rua0/Duke_Xprize_Hybrid/Past_reports_stuffs/2017S/Hybrid gas electric Power for Drone-UAS Sp17/coupling.jpg

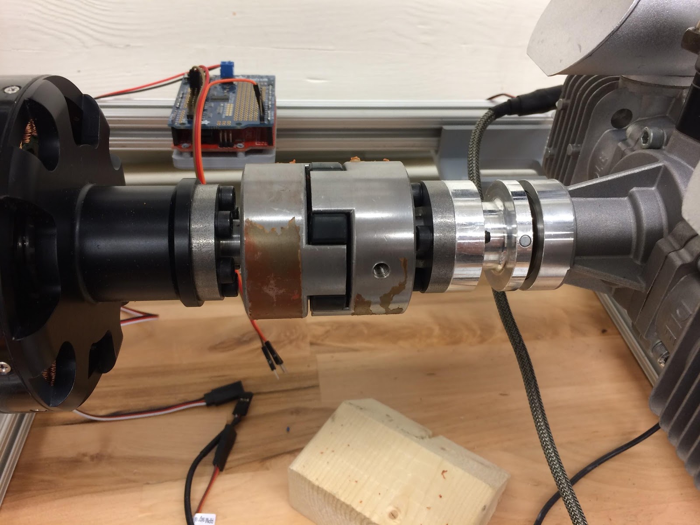
Past_reports_stuffs/2017S/Hybrid gas electric Power for Drone-UAS Sp17/coupling.jpg
