rua0/Duke_Xprize_Hybrid/README.md

# Duke_Xprize_Hybrid
Codes and documents for a hybrid-electrical system used for Duke Ocean Xprize entry
