rua0/Duke_Xprize_Hybrid/Past_reports_stuffs/F17 Hybrid/Copy of  9_22_16 - Zach Meeting.docx

Zach Meeting

1. NEVER Go straight from 1 to 6. There is an order somewhere we need to follow. Going from 1 to 6 will fuck up the ESC
  a. This is probably what we did week 1 and why it does not work anymore
2. RC Mimic attempts to get access to programming mode, but it is VERY finicky. Not deterministic, just need luck to get it right
  a. Once this happens, there are instructions for programming
  b. Let’s try to get a joystick to program?

Let’s split into 2 projects:

1. Joystick + ESC Happiness
  a. Get a joystick and try to program the ESC (higher probability than programming with Arduino)
    i. ESC still may lose programming afterwards
  b. If not work, fall back on using rc_mimic and dumb luck
2. Relay switching system
  a. Relay to switch between discharging and charging batteries
  b. Would need to program ESC to stop sending signals once charging
3. Potentially research more ESCs to see if something would fit our purpose better
