rua0/Duke_Xprize_Hybrid/Past_reports_stuffs/F17 Hybrid/Copy of 9_17_16 - Questions for Zach.docx

Does the wire polarization ( red-red and black-black) to battery need to be flipped when charging vs. receiving power?

Need to verify which direction to run motor for proper battery charge polarity

Ask about their troubleshooting

If they ever had any esc unhappy beep problems

Was the ESC programming through arduino straightforward?

Zach Meeting

1. NEVER Go straight from 1 to 6. There is an order somewhere we need to follow. Going from 1 to 6 will fuck up the ESC
  a. This is probably what we did week 1 and why it does not work anymore
2. RC Mimic attempts to get access to programming mode, but it is VERY finicky. Not deterministic, just need luck to get it right
  a. Once this happens, there are instructions for programming
  b. Let’s try to get a joystick to program?
1. Joystick + ESC Happiness
2. Relay switching system
