rua0/Duke_Xprize_Hybrid/Past_reports_stuffs/F17 Hybrid/Copy of ESC Programming.docx

5 is good

6 is good

7 is bad

Throttle

Max PL: 1925 us (closed) (134 deg)

Min PL: 1250 us (open) (68 deg)

Choke

Max PL: (Fully opened, maximum air) -60%, 1200 us (63 deg)

Min PL: -35 (max gas, final air), 650 us (10 deg)
