rua0/Duke_Xprize_Hybrid/Past_reports_stuffs/2017S/Hybrid gas electric Power for Drone-UAS Sp17/Circuit diagrams.docx

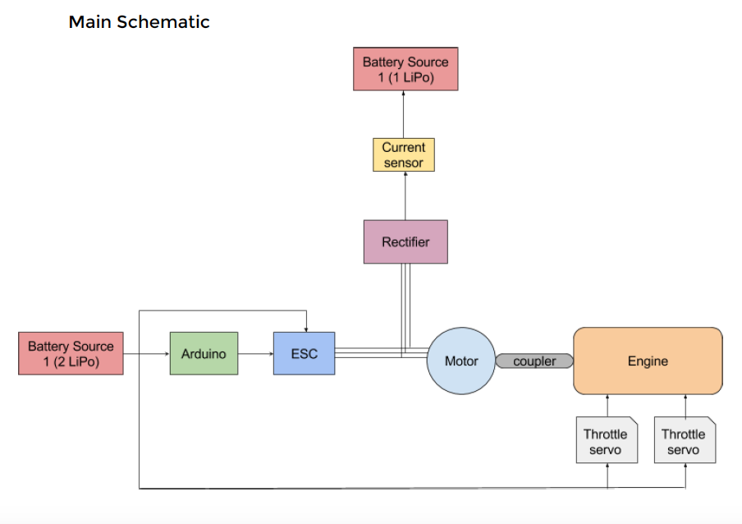
[picture p17: figure]

Load Resistance

(series)

Our schematic diagram only differs in that the load resistance has been connected to the rectifier. However everything else is the same.

This is how all the main components are connected together.

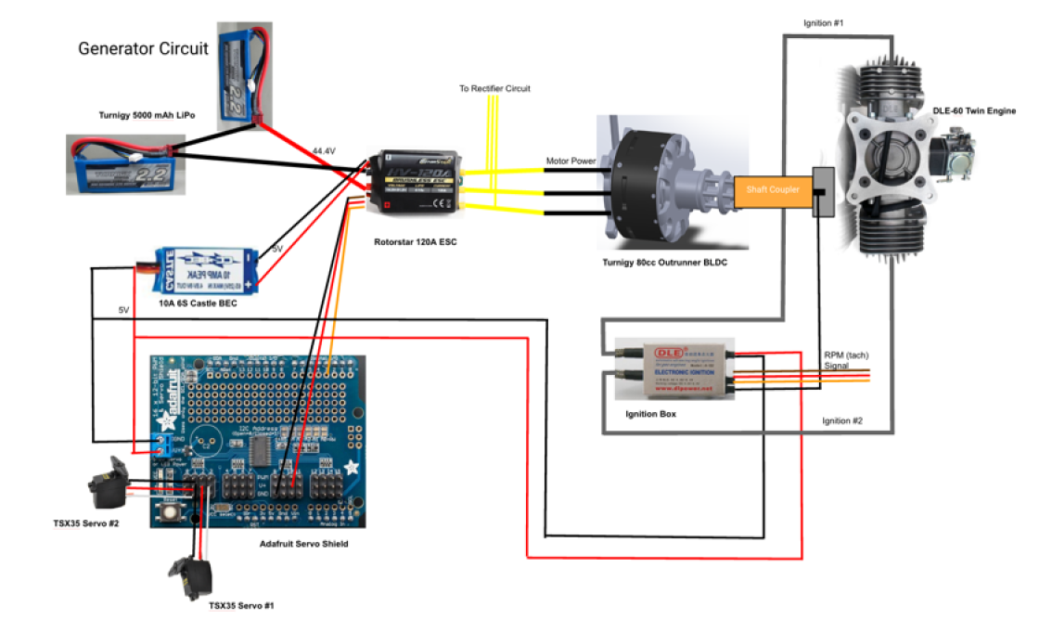
[picture p18: figure]

This is the rectifier circuit which now has the load resistance connected to it:

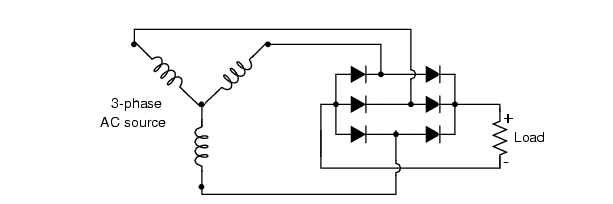
[picture p19: figure]
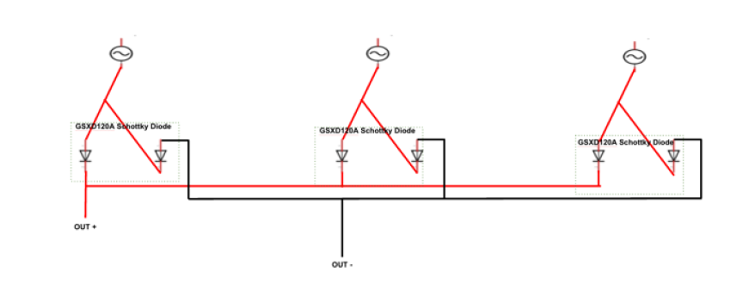
[picture p20: figure]
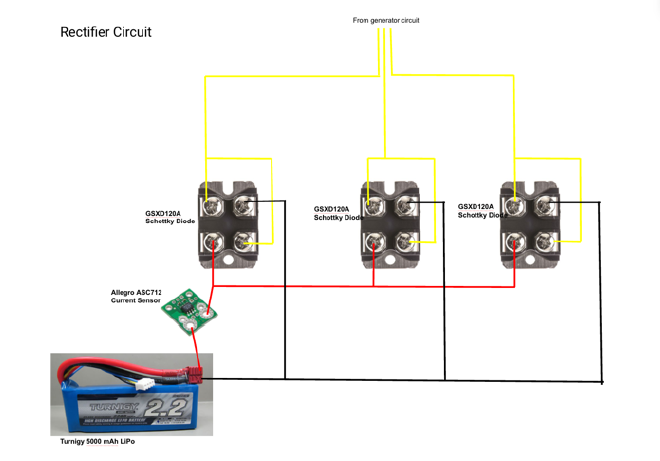
[picture p21: figure]
