rua0/Duke_Xprize_Hybrid/Past_reports_stuffs/2017S/Hybrid gas electric Power for Drone-UAS Sp17/Programmable ESC/Copy of Hybrid Gas-Electric Electronic Speed Controller (Final).docx

# Hybrid Gas-Electric Electronic Speed Controller

Will Floyd-Jones

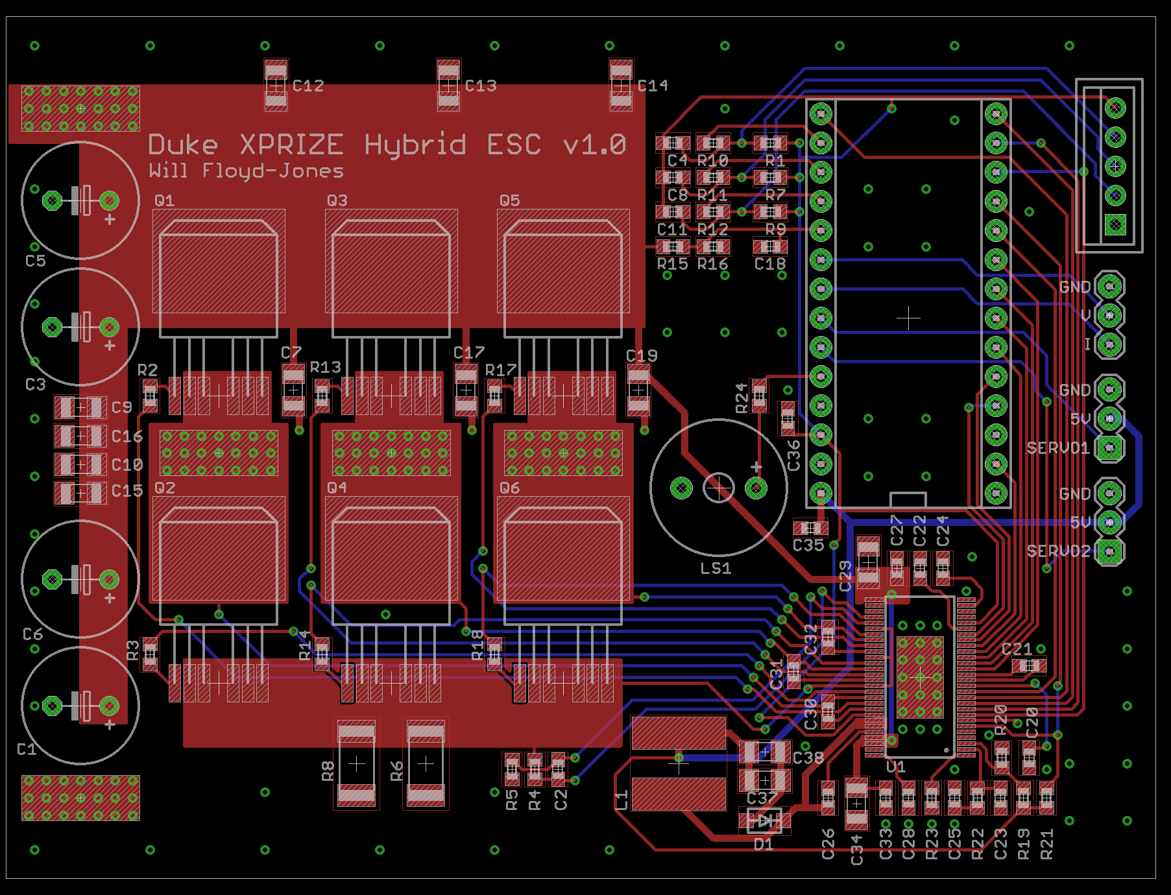
[picture p32: figure]

Overview

This report documents progress I have made on the electronic speed controller (ESC) for the hybrid gas-electric power system. I have designed a printed circuit board for the ESC which integrates a Teensy microcontroller, gate driver IC, hall effect sensor inputs, a buzzer, and connectors to interface with other components in the hybrid system. In addition, I have written Teensy firmware to interface the microcontroller with the gate driver IC and apply currents to the motor phases according to the hall effect state and throttle position. The ESC is able to spin a large brushless DC motor with hall effect sensors spaced 120 electrical degrees apart from one another.

Instructors: Dr. Martin Brooke

ECE 496 - Advanced Robotic System Design

Duke University

Table of Contents

Background 2

Schematic 5

Layout 8

Assembly 11

Hall Effect Sensor Board 11

Code 12

Status and the Way Forward 14

Background

Brushless DC motors are gaining in popularity due to their efficiency advantage over their brushed counterparts. The brushes of a conventional motor are used to mechanically commutate the device- meaning that they apply current to the coil windings to swap the direction of the magnetic field. This makes turning a brushed DC motor very simple: apply DC current and the motor will spin. However, these brushes can wear out over time and efficiency losses occur due to arcing and suboptimal management of the magnetic field orientation.

Brushless motors require the system designer to electronically commutate the device- a microcontroller is used to apply currents to the coil windings based on the position of the rotor relative to the stator. The stator coil generates a rotating magnetic field which drags the rotor through each successive revolution. Since the relative position of the rotor must be known to determine which direction currents should travel through the stator windings, three hall-effect sensors are often embedded in the stator and used to indicate 6 unique rotor positions. As the rotor magnet passes over one of the hall-effect sensors, its output will switch from low to high. The figure below illustrates a brushless DC motor in a inrunner topology- that is, the rotor is on the inside and the stator is on the outside- with hall-effect sensors on the non-driving end.

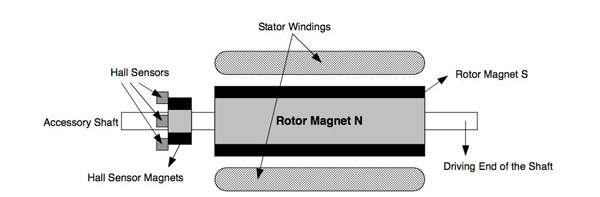
[picture p33: figure]
Microchip Hall sensors

Figure 1: Inrunner-style brushless DC motor

There are more sophisticated ways to detect the rotor position- encoders which give far better resolution than the simple hall effect sensor topology, or a sensorless strategy which measures the back-EMF from the rotating motor’s phases to infer the rotor position. These complicate the system design but can be used to enhance reliability and efficiency. However, in the hybrid gas-electric system on the drone, the ESC only exists to start the motor. This means that it does not have to be very efficient since it is not on for very long and only drains the battery which is used only to start the motor. The sensorless strategy relies on back-EMF produced by a rotating motor- meaning that it cannot be used to start rotating the motor. Typically this is overcome by rotating the motor open-loop until it is going fast enough to produce sufficient back-EMF, but the motor torque will be low while it is being spun open-loop because the magnetic field will not be well-oriented. Again, the ESC in the hybrid system is for starting the motor- nothing else- so it would be foolish to employ a sensorless strategy where the motor would struggle to produce enough torque to drive the gas engine.

The stator of a brushless DC motor is comprised of three sets of coil phase windings, which are attached at a common point in the center as shown in Figure 2 below. The motor has three terminals- one for each stator phase- which connect to the ESC’s drive phases. These drive phases, shown in Figure 3 below, apply currents to the stator using three MOSFET pairs- which are used to drive one motor phase high and another low while the third is left floating. It is up to the system designer to ensure that the high side and the low side of a single drive phase are never on at the same time- this would cause a short between the positive and negative battery terminals through the drive phase’s MOSFETs. If hall-effect sensors are used for determining the rotor position, a simple look-up table can be used to select which MOSFETs to turn on based on the hall-effect sensor states.

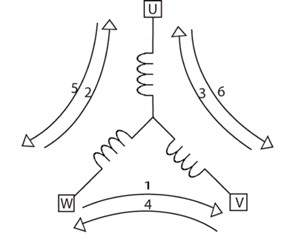
[picture p34: figure]
Atmel Coil-energizing sequence

Figure 2: Y-Configuration of stator coils

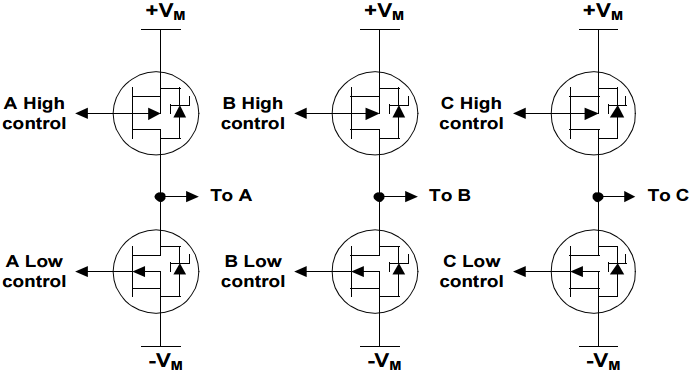
[picture p35: figure]

Figure 3: 3- Half H-bridge MOSFET drive phase schematic

Schematic

The schematic capture and PCB layout for this project were done in EAGLE. I selected EAGLE over more capable tools such as Altium Designer because this PCB is not too complex and EAGLE is still the standard among hobbyists and should be the easiest to use if this design is re-used or modified in the future. The schematic contains sections for decoupling capacitors, the hall-effect sensor inputs, connectors, the gate driver IC, the MOSFET drive stages, and the Teensy microcontroller.

The hall-effect sensor portion of the schematic consists of a 5-pin polarized JST connector for power, ground, and the three inputs. The inputs are pulled up to 3.3V (the microcontroller digital IO operating voltage) by a 10k resistor because the hall effect sensors are open-collector. They are filtered with a simple RC low-pass filter with a cutoff frequency of 16 Khz and a 10% to 90% rise time of 22 µs. These values can easily be changed later as necessary by replacing either the resistor or capacitor (or both) from the board.

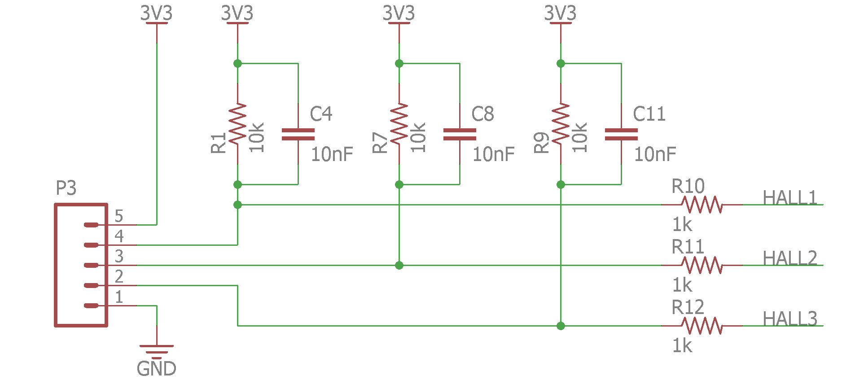
[picture p36: figure]

Figure 4: Hall-effect sensor input schematic

The drive stages portion of the schematic consists of the canonical configuration of three half-H bridges used to pull each of the motor terminals to V+ or ground. The MOSFETs used can conduct up to 240A. At the bottom, the node labeled “FET_LOW” connects the source terminals of the low side MOSFETs to ground through a pair of shunt resistors in parallel, which are used to measure the sum of the currents through the motor. Due to a slight schematic error, the current shunt amplifier output of the DRV8301 IC is not wired to the microcontroller, so gate current cannot be monitored in this board revision.

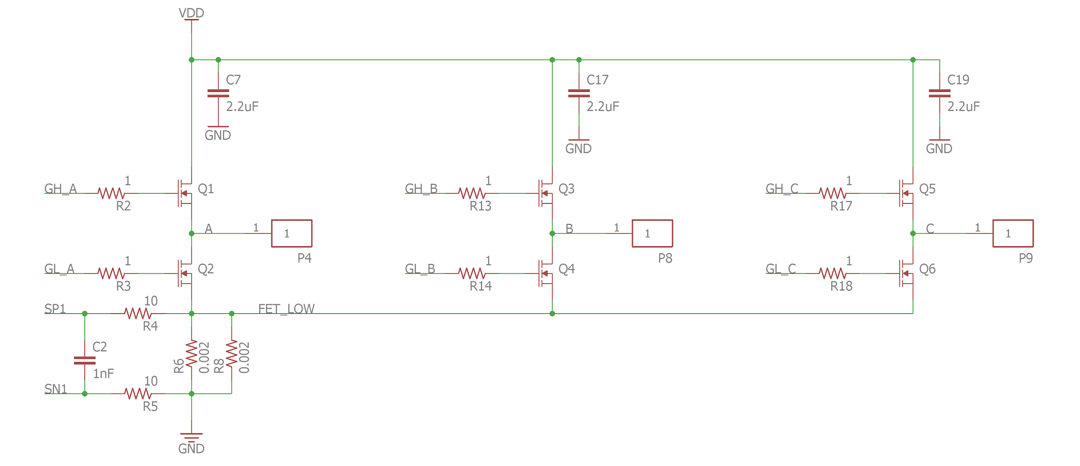
[picture p37: figure]

Figure 5: Drive Stages schematic

The DRV8301 gate driver portion of the schematic is for the most part the schematic recommended in the Texas Instruments application note. The ICs integrated buck converter is used to produce the 5V rail for the rest of the chip.

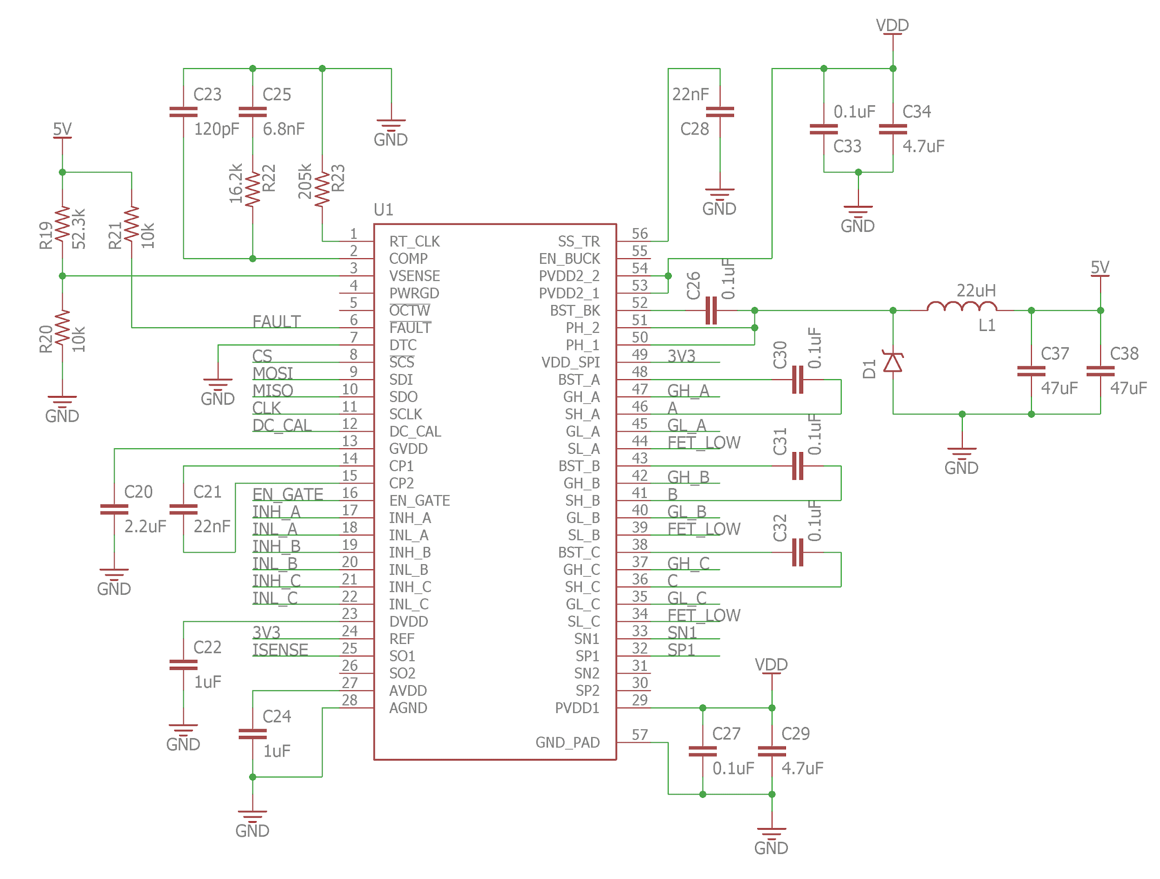
[picture p38: figure]

Figure 6: Gate Driver IC Schematic

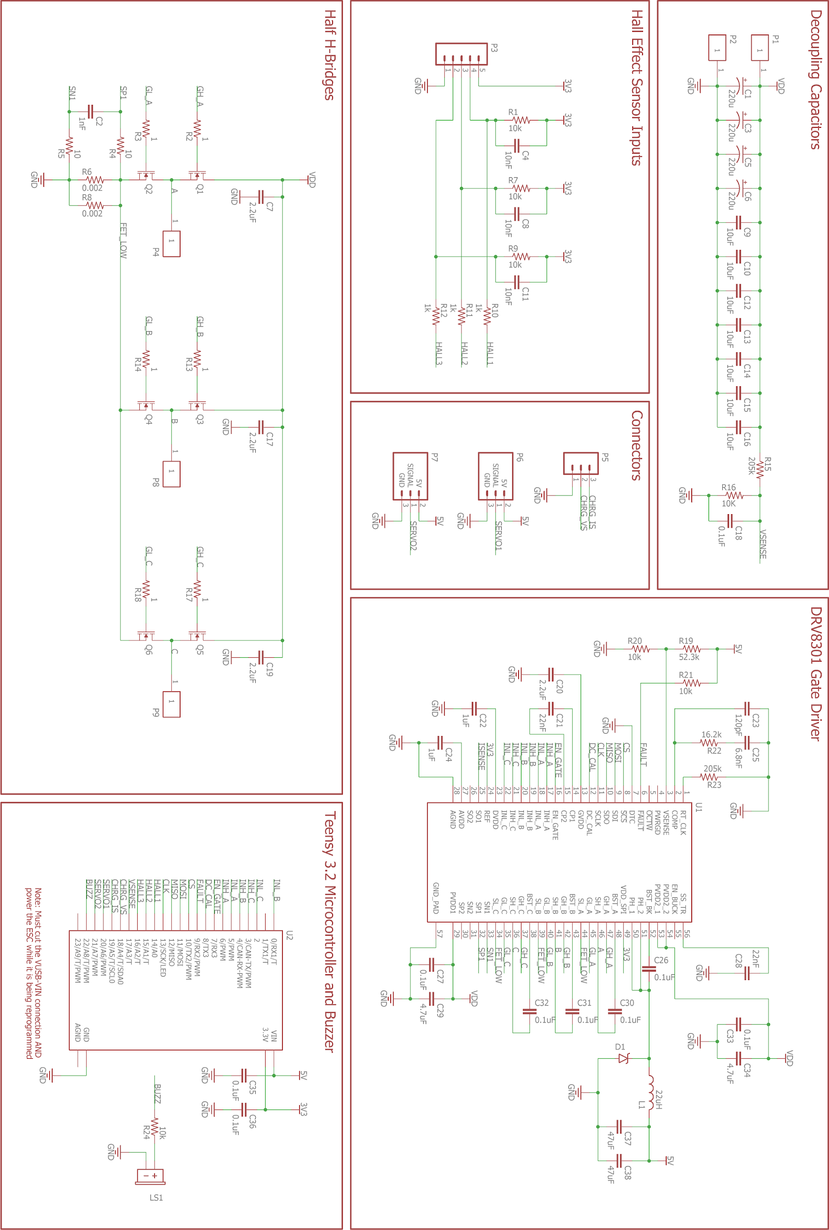
[picture p39: figure]

Figure 7: Complete Schematic

Layout

The PCB is laid-out with the drive stages on the left side and the microcontroller and gate driver IC on the right side. The drive stages are positioned such that enough current can flow between the motor terminal and the MOSFET gates; the traces connecting the high and low side MOSFETs to the motor terminal are each about 12 mm wide. Given that the circuit board will likely be fabricated with 1 oz/ft² copper and most of the trace is actually covered with solder, each trace should easily conduct more than 30A. Under the drive stages is the low-side current sensor system, which shunt current through a pair of 2 mΩ resistors of size 2512 in parallel and amplify the voltage using the gate driver IC. This copper pour should be large enough to conduct the current necessary to start the gas motor. The left side of the board also contains the decoupling capacitors on the input and pads to connect to the silicon wires of the battery connector and the motor phase wires. These pads are wide enough to accommodate 10 AWG wire and have vias through them to help prevent mechanical stress from ripping the pad off the PCB.

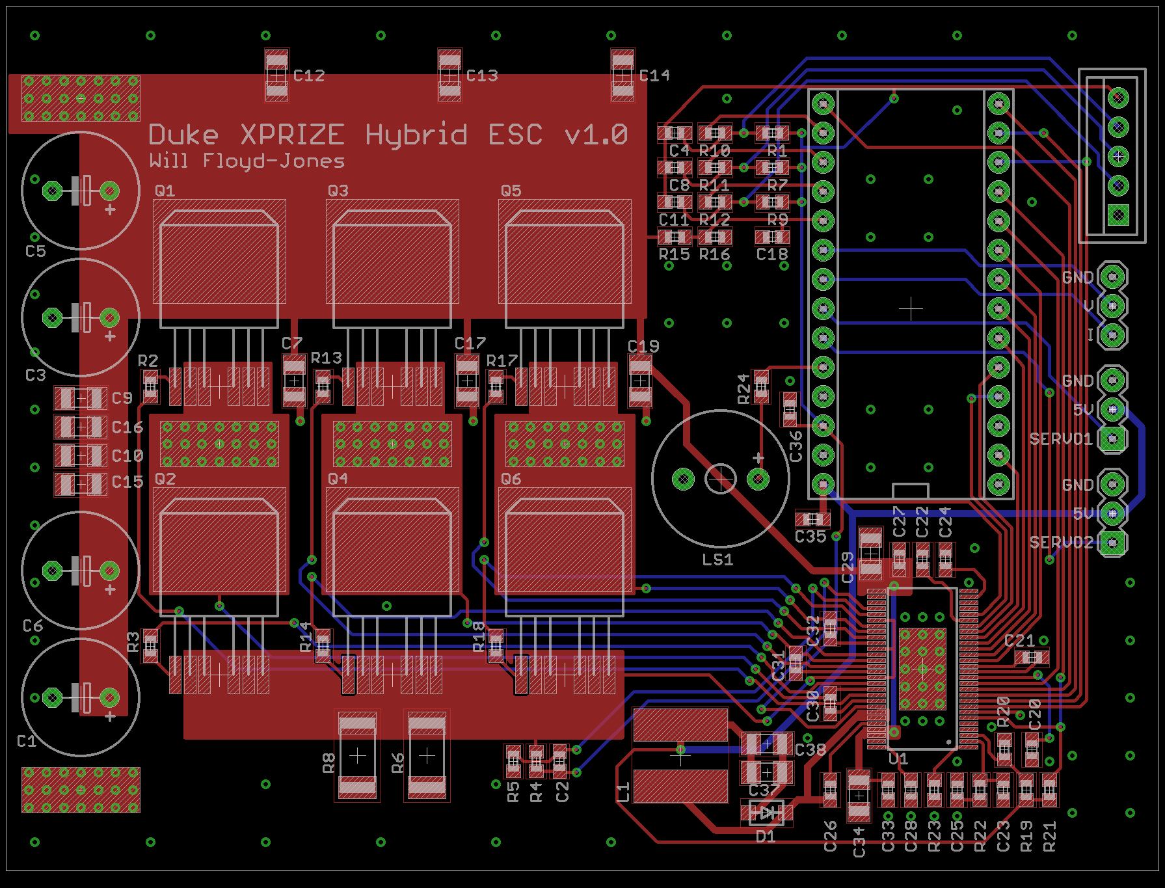
[picture p40: figure]

Figure 8: PCB Layout

On the right side of the board, the gate driver is fanned out such that the ground pour on the bottom side of the board is continuous and can reach the IC. There are a large number of stitching ground vias on and around the IC pad to provide thermal relief minimize ground impedance. Pins on the gate driver IC which conduct relatively higher currents are surrounded with polygon pours. The right side of the board also contains connectors for the Teensy microcontroller footprint- a pair of 14-pin 0.1” pitch female headers. There are no components placed underneath the Teensy footprint in case it is desired to solder the microcontroller directly (without female headers), as this would diminish the likelihood that there should be a reason to remove the microcontroller to make board modifications. The connectors to the pair of servo motors, to the hall effect sensor cable, and to the buffer battery’s voltage and current sensors are positioned on the far right side of the board. This way the five power leads will come off the left side of the board, and the four communication cables will come off the right side of the board.

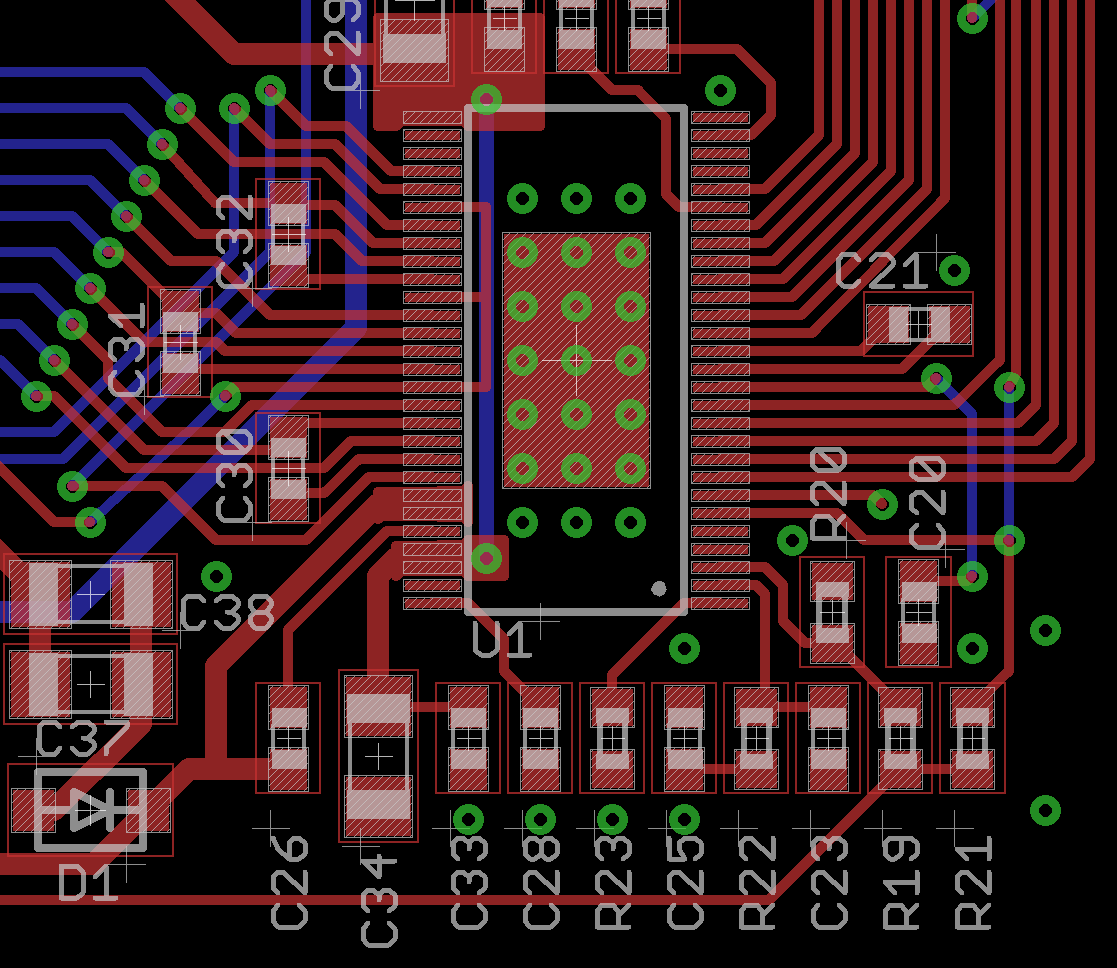
[picture p41: figure]

Figure 9: Gate driver portion of PCB layout

The board is 75 mm wide and is intended to be housed in the extruded aluminum Hammond Manufacturing enclosure. There is about 2 mm of space on the top and bottom of the PCB such that is can be slotted into the enclosure. The PCB is just able to fit into the 16.31 mm space between the top of the bottom slot and the top of the enclosure. Since the enclosure is metal, it may be wise to use nonconductive tape on the edges of the board to prevent accidental shorts.

Assembly

Assembly of the design was achieved via solder paste stencil and hand pick-and-place. The SMD components were individually placed on the solder and reflowed using the Reflow Chateau, my custom reflow oven. This reflow oven is located in Hudson 113b, and can be used to reflow boards according to an adjustable temperature versus time profile. The peak temperature specified in the reflow profile was 230 C, which is reasonably high, to compensate for the high thermal mass of the drive MOSFETs.

Hall Effect Sensor Board

The purpose of the hall effect sensor board is to determine the location of the rotor relative to the stator. As is common in electric bike hub motors, the hall effect sensors are mounted 120 electrical degrees apart from one another. The conversion from mechanical degrees to electrical degrees is defined as follows:

Mechanical degrees per electrical degree = 360/(rotor pole pairs)

Since it was nearing the end of the semester when I actually got the ESC to spin a motor, I did not have time to wait the ~2 weeks for custom hall effect sensor boards to arrive. I decided to use a desktop mill to produce a single-sided FR2 board with a 5-pin JST XH connector and 3 ATS177 hall effect sensors. It is difficult to use the mill to produce 2-sided boards since the board needs to be flipped over and re-aligned, so I milled a single-sided board with the signal traces, and hand-wired the power and ground traces on the other side. The sensors are spaced on the board by 12 mechanical degrees, assuming there are 10 magnet pole pairs on the rotor. I got the value of 10 magnet pole pairs from the HobbyKing motor page, but now have reason to suspect that this value is not correct.

Unfortunately, when I mounted the hacked-together hall effect sensor board to the generator motor intended for use on the drone, I recorded an invalid hall effect state of 3’b111, which indicates that there is a problem with the sensor alignment. It is possible that there are problems with the board dimensions or the sensors are a bit askew, but I suspect that the issue is the assumption that the sensors need to be mounted 12 degrees apart.

Code

The code is intended to be maximally simple. The functions I have written and their descriptions are as follows:

setup(): Called when the microcontroller turns on. Calls setup_pins() and attaches pin change interrupts to all three hall effect sensor input pins so that the gate state can be updated to reflect changes in the hall effect sensor state.

setup_pins(): Called by setup(). Sets the pin modes of each of the input and output pins. Calls functions to setup the SPI communication with the DRV8301 gate driver IC and initializes this IC. Changes the analogwrite frequency to 8kHz to be able to PWM the high-side MOSFETs at a high rate.

spi_read(): Reads SPI data from the given address. Called only to test DRV8301 initialization for now.

spi_write(): Write given data to the given address. Unused for now.

interp_linear(): Called by get_throttle(). Performs simple linear interpolation. Takes an input value called val, which is on some range [in_min, in_max] and remaps it to some output range [out_min, out_max]. Doesn’t allow the output to be out of the output range.

get_throttle(): Called by loop(). Reads the throttle from an analog input pin (we’re assuming that the throttle command is given by a voltage between 0V and 3.3V) and scales it to a floating point value between 0 to 1.0.

hall_ISR(): Called as a pin-change interrupt every time one of the three hall-effect sensors changes state. Determines the state of the hall sensors by calling get_hall_state(), uses a hard-coded look up table to figure out how to switch the MOSFETs, changes the states of the MOSFETs accordingly by calling write_state().

get_halls(): Called by hall_ISR(). Reads each of the three hall effect sensor pins and bit-shifts the results to assemble them into an unsigned integer.

write_state(): Called by hall_ISR(). Takes in a position and uses a switch statement to write the appropriate state to the high-side MOSFETs and the low-side MOSFETs.

write_low(): Called by write_state(). Writes the given value to each of the three low-side MOSFET pins on the gate driver IC.

write_high(): Called by write_state(). Writes the given value to each of the three high-side MOSFET pins of the gate driver IC. There are three cases which apply current to the stator- in each case two of the MOSFETs are off while the thirds is PWMed according to the “throttle” value. The throttle will likely be a global variable that is some function of time. It will ramp up from 0 to 255 such that the gas motor can start.

One critical piece of the code is the global constant variable hall_order, which is an array that specifies the state to write to the MOSFET gates according to the given hall effect state. Determining this order is slightly tricky. When the motor is rotated by hand and the hall effect states are printed to the serial monitor, the variable “pos” in the hall_isr function should go [5, 4, 3, 2, 1, 0, 5, 4, 3…].

Another important piece of the code is the HALL_SHIFT constant, which determines how to shift the hall_order variable to align to the correct hall state. To determine this variable, increment it from 0 to 5 (inclusive) while trying to spin up the motor. If this fails to spin the motor at any value, swap any two of the motor phase wires and try again from 0 to 5. One of these 12 different states should correctly spin the motor.

Status and the Way Forward

Currently this design can be used to spin motors. The existing code can determine the state of the hall effect sensors and use this to select the state of the drive phases, but it does not do much more. It would be nice if a future version of the code had a mode which could automatically compute the hall effect sensor lookup table by spinning up the motor open-loop while recording the hall effect sensor states.

The current design has an important error on the board: the current sensor output of the gate driver IC is not connected to the microcontroller. The current sensor on the gate driver is intended to be used to detect over-current problems in the system, so it might be wise to run a green wire from the DRV8301 to a Teensy analog input pin.

To get the hybrid motor to spin, a hall effect sensor board needs to be fabricated. It just needs 3 sensors and a 5-pin JST XH connector for the 3 signals, 3.3V, and ground. Since I’ve had problems with this, it’s currently not clear how the sensors need to be spaced. But the sensor board is mounted and the sensor states are 1-6 instead of the dreaded invalid 0 and 7 states, it shouldn’t be too tough to get the motor spinninng.
