rua0/Duke_Xprize_Hybrid/Past_reports_stuffs/2017S/Hybrid gas electric Power for Drone-UAS Sp17/Team Hydra/Meeting Notes/10_21_16.docx

How is current generated when using the BLDC Generator?

How is that controlled

What is the power consumption of the copter?

Questions for neal simmons

Design new linkage that have set positions
