rua0/Duke_Xprize_Hybrid/Past_reports_stuffs/2017S/Hybrid gas electric Power for Drone-UAS Sp17/Team Hydra/Meeting Notes/10_25_16.docx

Meeting Notes

- No way to get giant voltage because a giant current is required and the diodes would stop them by them
- Motor is a current source that is dependent on engine speed
- DC motor would be too heavy
- Try a voltage divider
  - Use it and a zener clamp to measure the voltage
