rua0/Duke_Xprize_Hybrid/Past_reports_stuffs/2017S/Hybrid gas electric Power for Drone-UAS Sp17/Team Hydra/Meeting Notes/12_6.docx

Reprogramming the ESC using a programming card

https://www.youtube.com/watch?v=4Kg7MzGwvdw

(https://www.youtube.com/watch?v=4Kg7MzGwvdw)https://www.youtube.com/watch?v=a7kbMhBaUA4

(https://www.youtube.com/watch?v=a7kbMhBaUA4)

Programming using the ESC card, when plugging the 3 cables, orange to the left

Left side: shorter cable of the ESC (orange to the left)

Right side: power (middle power, right one ground)

Settings: 12 cells, no brake

1st run:

Voltage went from 22.4 to 22.8V
