rua0/Duke_Xprize_Hybrid/Past_reports_stuffs/2017S/Hybrid gas electric Power for Drone-UAS Sp17/Team Hydra/Meeting Notes/9_23_16.docx

Meeting Notes 9-23-16

Meeting @ The Foundry

Member | Present
Brooke
Henry | ✓
Garrett | ✓
Tamra | ✓
Raiyan | ✓
Jihan | ✓
Edward | ✓

RC Joystick Programming

- Six Beeps and then silence indicates it detects six cells - generally the state that you want
- Pretty clear
  - Leave lever up before starting to program
  - Pull down after continuous beeps to indicate what setting you want
- Were able to reprogram
  - Disabled Brake and Governor
    - Joystick control stopped working after braking was disabled
- Noticed that the period that the transceiver wrote at was different than that of what the arduino wrote
  - Double check this?
