rua0/Duke_Xprize_Hybrid/Past_reports_stuffs/2017S/Hybrid gas electric Power for Drone-UAS Sp17/Team Hydra/Our Documentation/All Connections.pptx

Generator Circuit

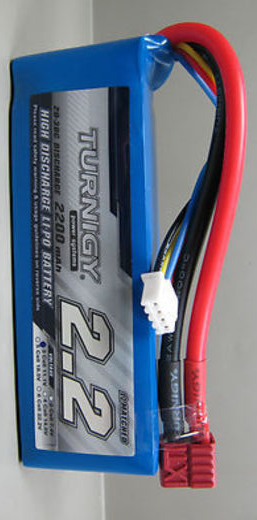
[picture p43: figure]

Ignition #1

Turnigy 5000 mAh LiPo

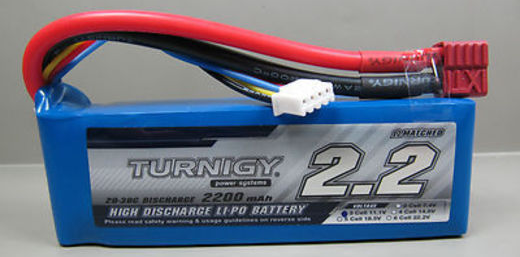
[picture p44: figure]

To Rectifier Circuit

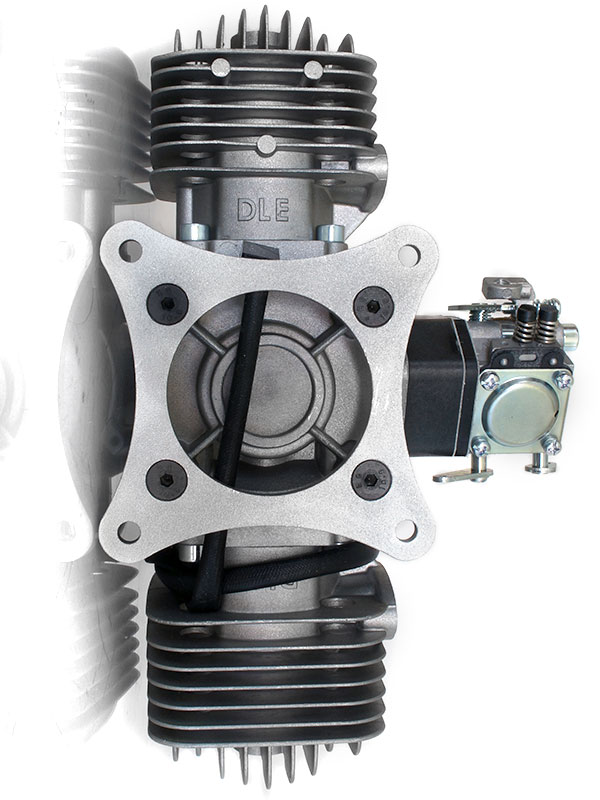
[picture p45: figure]

DLE-60 Twin Engine

44.4V

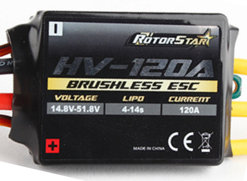
[picture p46: figure]

Rotorstar 120A ESC

Motor Power

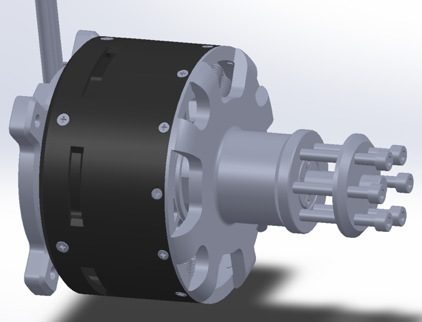
[picture p47: figure]

Turnigy 80cc Outrunner BLDC

5V

Shaft Coupler

10A 6S Castle BEC

5V

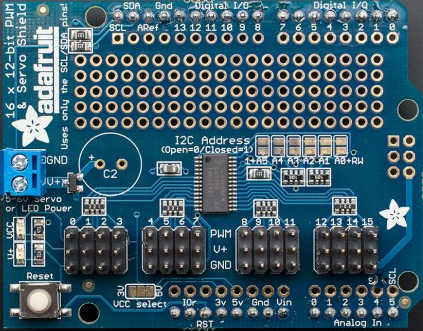
[picture p48: figure]

Adafruit Servo Shield

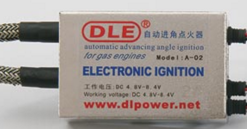
[picture p49: figure]

Ignition Box

RPM (tach) Signal

Ignition #2

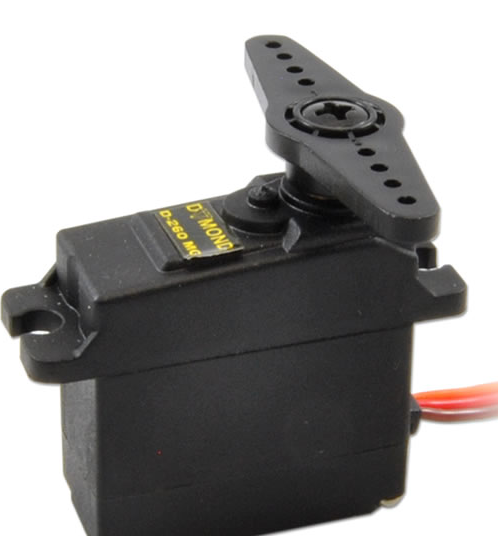
[picture p50: figure]

TSX35 Servo #2

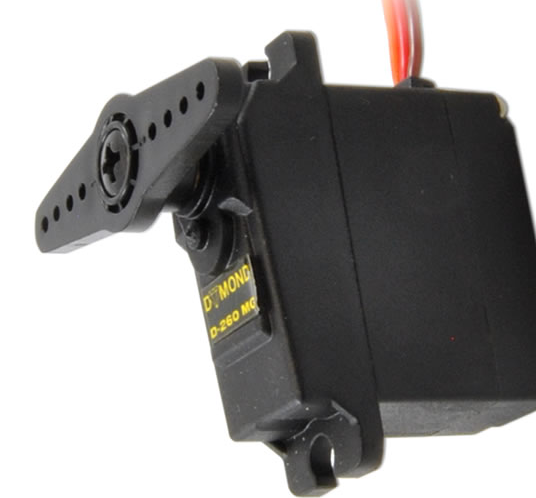
[picture p51: figure]

TSX35 Servo #1

## Slide 2

Rectifier Circuit

From generator circuit

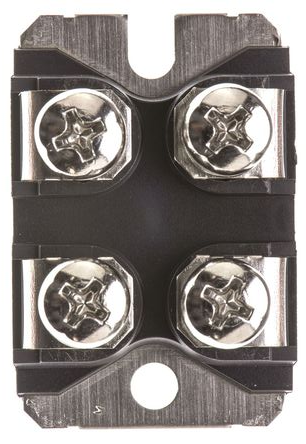
[picture p52: figure]

GSXD120A Schottky Diode

GSXD120A Schottky Diode

GSXD120A Schottky Diode

Allegro ASC712 Current Sensor

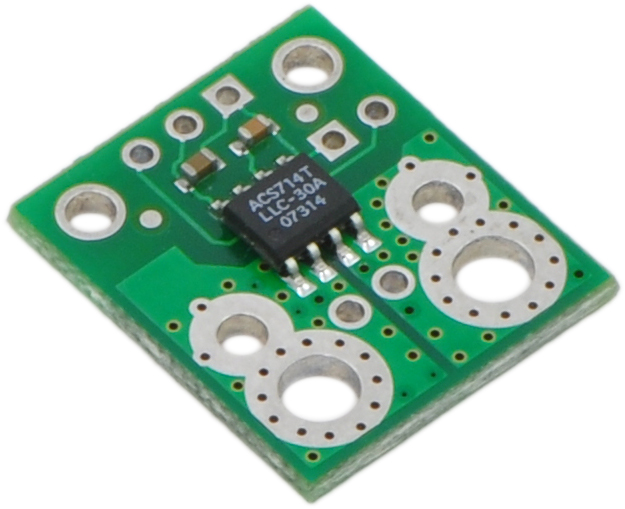
[picture p53: figure]

Turnigy 5000 mAh LiPo

## Slide 3

GSXD120A Schottky Diode

GSXD120A Schottky Diode

GSXD120A Schottky Diode

OUT +

OUT -
