rua0/Duke_Xprize_Hybrid/Past_reports_stuffs/2017S/Hybrid gas electric Power for Drone-UAS Sp17/Team Hydra/References/Power Calculations.xlsx

 | Min Current | Kv (RPM/V) | Nom Voltage | Min RPM | Max RPM | Calculations |  |  | Units
Rotor (https://hobbyking.com/en_us/turnigy-multistar-4830-480kv-22pole-multi-rotor-outrunner.html) | 22 | 480 | - | - | - | Minimum RPM for 22.3V | Kv*22.3 | 4348.5 | W
Battery | - | - | 22.3 | - | -
DLE 60 ICE (http://downloads.hobbico.com/factsheets/dle/dleg0060-fact-sheet.pdf) | - | - | - | 1400 | 8500
Turnigy 80cc BLDC | - | 195 | - | - | -
