rua0/Duke_Xprize_Hybrid/Past_reports_stuffs/2017S/Hybrid gas electric Power for Drone-UAS Sp17/Circuit diagrams(1).docx

Load Resitsance

(series)

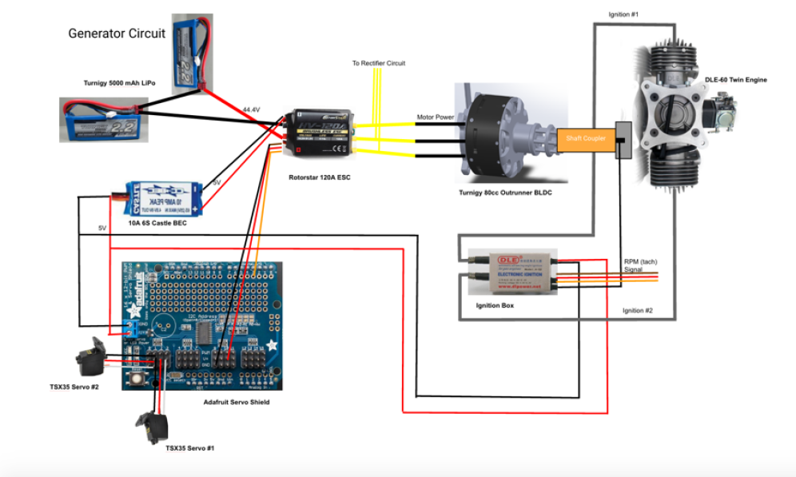
[picture p100: figure]

Circuit diagrams
