rua0/Duke_Xprize_Hybrid/Past_reports_stuffs/F17 Hybrid/DC Load_.jpg

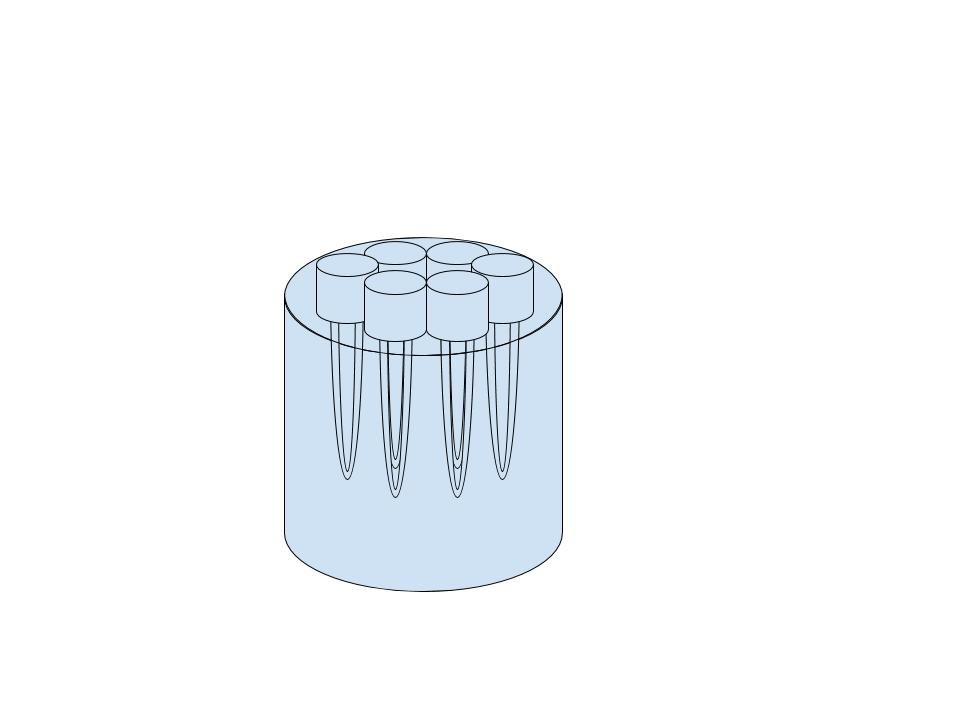
Past_reports_stuffs/F17 Hybrid/DC Load_.jpg
