rua0/Duke_Xprize_Hybrid/Past_reports_stuffs/F17 Hybrid/List of Parts Needed for Hydro Team.xlsx

Item | Cost ($) | Quantity | Total ($) | Link | Comment
Fuel Line Hose | 5.98 | 1 | 5.98 | https://www.amazon.com/HIPA-10-Feet-Petrol-Tubing-Common/dp/B00V9XS07C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 | HIPA 10-Feet (3 Meter) Petrol Fuel Line Hose I.D 3/32" x O.D 3/16" Tubing for Common 2 Cycle Small Engine
3Pin Balancer Pin | 11.59 | 1 | 11.59 | https://www.amazon.com/20Pairs-Female-Balancer-Charger-Connectors/dp/B071P2576K?s=toys-and-games | 20Pairs 2S 3Pin JST XH Male and Female Balancer Charger Connectors
2S 1.8Ah Lipo Battery | 17.99 | 1 | 17.99 | https://www.amazon.com/Turnigy-nano-tech-1800mah-25-50C-AIRSOFT/dp/B00TDCBWPS | Turnigy nano-tech 1800mah 2S 25~50C Lipo AIRSOFT Pack
XT90 | 19.98 | 1 | 19.98 | https://www.amazon.com/ARRIS-Anti-Spark-Connector-Battery-Charger/dp/B00XXNSEBS | This package contains 5 pairs of XT90 male-female pair
5 Gal Bucket | 2.97 | 2 | 5.94 | http://www.homedepot.com/p/The-Home-Depot-5-Gal-Homer-Bucket-05GLHD2/100087613 | Bucket for heater
Bucket Lid | 1.38 | 2 | 2.76 | http://www.homedepot.com/p/Leaktite-5-Gal-Reusable-Bucket-Lid-6GLDBLK30/202264045 | Bucket lid
 |  |  | 0
 |  |  | 0
 |  |  | 0
 |  |  | 0
 |  |  | 0
