rua0/Duke_Xprize_Hybrid/Past_reports_stuffs/2017S/Hybrid gas electric Power for Drone-UAS Sp17/Team Hydra/Parts/Purchase Orders/BOM.xlsx

Part | Mfg P/N | Where to get | Data Sheet | Notes | Price | Total
Engine | DLEG0060 | DLE Engines Website (http://www.dle-engines.com/dleg0060.html) | http://manuals.hobbico.com/dle/dleg0060-manual-v2.pdf
BEC | 010-0004-00 | Amazon Prime, baby (https://www.amazon.com/Castle-Creations-Bec-Switching-Regulator/dp/B000MXAR12) | http://www.castlecreations.com/products/ccbec.html
BLDC | 9192000070 | Hobby King Website (http://www.hobbyking.com/hobbyking/store/__25410__Turnigy_RotoMax_80cc_Size_Brushless_Outrunner_Motor_195kv_.html) | None so far
BLDC | 9351000042-0 | Hobby King Website (http://www.hobbyking.com/hobbyking/store/__55384__RotorStar_120A_HV_4_14S_Brushless_Speed_Controller_OPTO_.html) | None so far | http://www.hobbyking.com/hobbyking/store/uploads/893329926X10239X17.pdf
Schottky Diodes |  | downstairs cabinet | http://www.gptechgroup.com/pdf/GSXD120A010S1-D3.pdf
8020 1010S x 3 in w/ end tap | 6 |  |  |  | 6.54 | 39.24
8020 1010S x 6 in w/ end tap | 8 |  |  |  | 7.23 | 57.84
8020 1010S x 7 in w/ 2 access holes at 0.5 and 6.5 | 1 |  |  |  | 7.26 | 7.26
8020 1010S x 11 in (w/ end tap) | 4 |  |  |  | 8.38 | 33.52
8020 1010S x 12 in (w/ end tap) | 2 |  |  |  | 8.61 | 17.22
8020 1010S x 16.5 in (w/ 2 access holes at 0.5 and 16) | 5 |  |  |  | 9.64 | 48.2
Economy T-nut | 52 |  |  |  | 0.61 | 31.72
 |  |  |  |  |  | 235
