rua0/Duke_Xprize_Hybrid/Past_reports_stuffs/2017S/Hybrid gas electric Power for Drone-UAS Sp17/Team Hydra/Parts/Purchase Orders/Purchase Order 10_22.xlsx

Item | Unit Price | # of Units | Shipping | Total | Purchase Source
Current Sensor | $14.99 | 2 | Choose Priority 1st Class | $29.98 | FPVHQ (https://www.fpvheadquarters.com/accessories/power-accessories/current-sensors/tbs-current-sensor-100a.html)
Step Down Buck Regulator 12V | $7.49 | 2 | - | $14.98 | Pololu (https://www.pololu.com/product/2834)
3.5mm bullet connectors | $3.50 | 2 | - | $7.00 | Amazon2 (https://www.amazon.com/Generic-3-5mm-Bullet-Connector-Battery/dp/B00EZKW1T4)
Screw Terminal | $10.92 | 2 | - | $21.84 | Amazon3 (https://www.amazon.com/Blue-Sea-Systems-Circuit-Terminal/dp/B000MMH1H6?s=automotive)
100A Relay | $39.97 | 3 | - | $119.91 | Mouser (http://www.mouser.com/ProductDetail/TE-Connectivity/1393315-2/?qs=Koa4dS0tnlE2nyG9X0NbuQ%3D%3D)
Rotorstar ESC | $95 | 2 |  | $190.00 | HobbyKing (http://www.hobbyking.com/hobbyking/store/__55384__RotorStar_120A_HV_4_14S_Brushless_Speed_Controller_OPTO_.html)
 | ****
 |  |  | Total: | $383.71
 |  | **** | We learned through idling on the page enough (~20-30 mins) that hobbyking will lower the price of the current product on the screen by ~$30 for a "one time offer". This might save some money.
