rua0/Duke_Xprize_Hybrid/Past_reports_stuffs/F17 Hybrid/dleg0060-dimensions.pdf

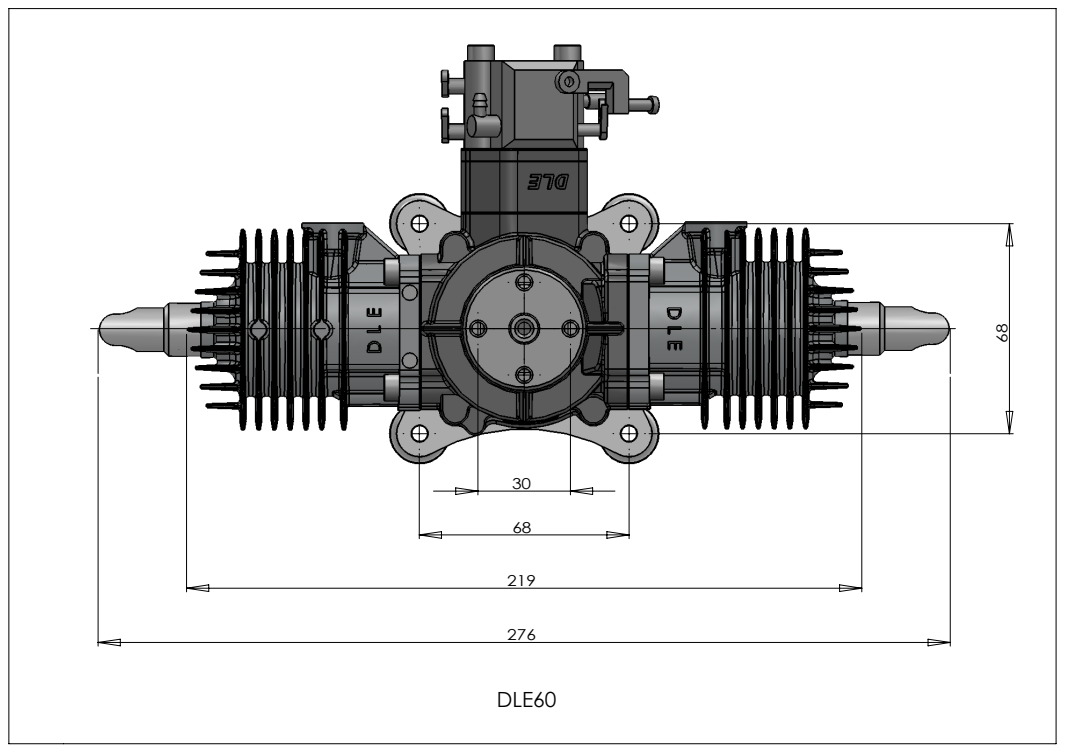
[picture p105: page 1]

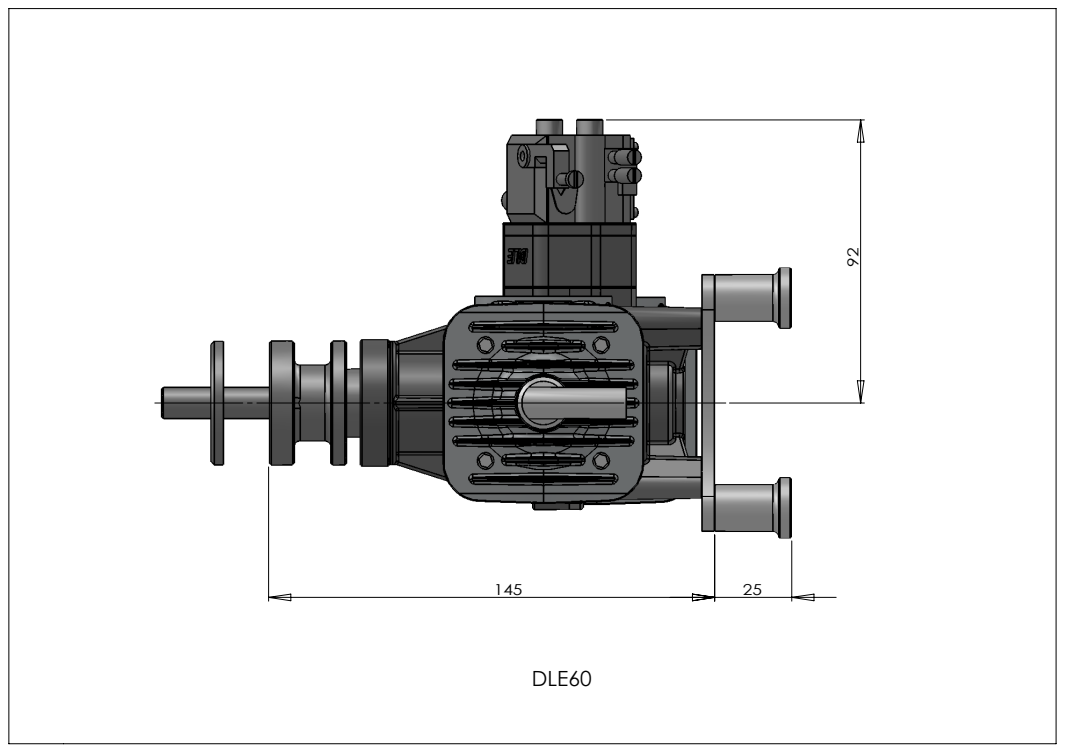
[picture p106: page 2]
