rua0/Duke_Xprize_Hybrid/Past_reports_stuffs/2017S/Hybrid gas electric Power for Drone-UAS Sp17/Programmable ESC/hybrid_esc_eagle/hybrid_esc.brd

## EAGLE design Past_reports_stuffs/2017S/Hybrid gas electric Power for Drone-UAS Sp17/Programmable ESC/hybrid_esc_eagle/hybrid_esc.brd (2018-06-21)

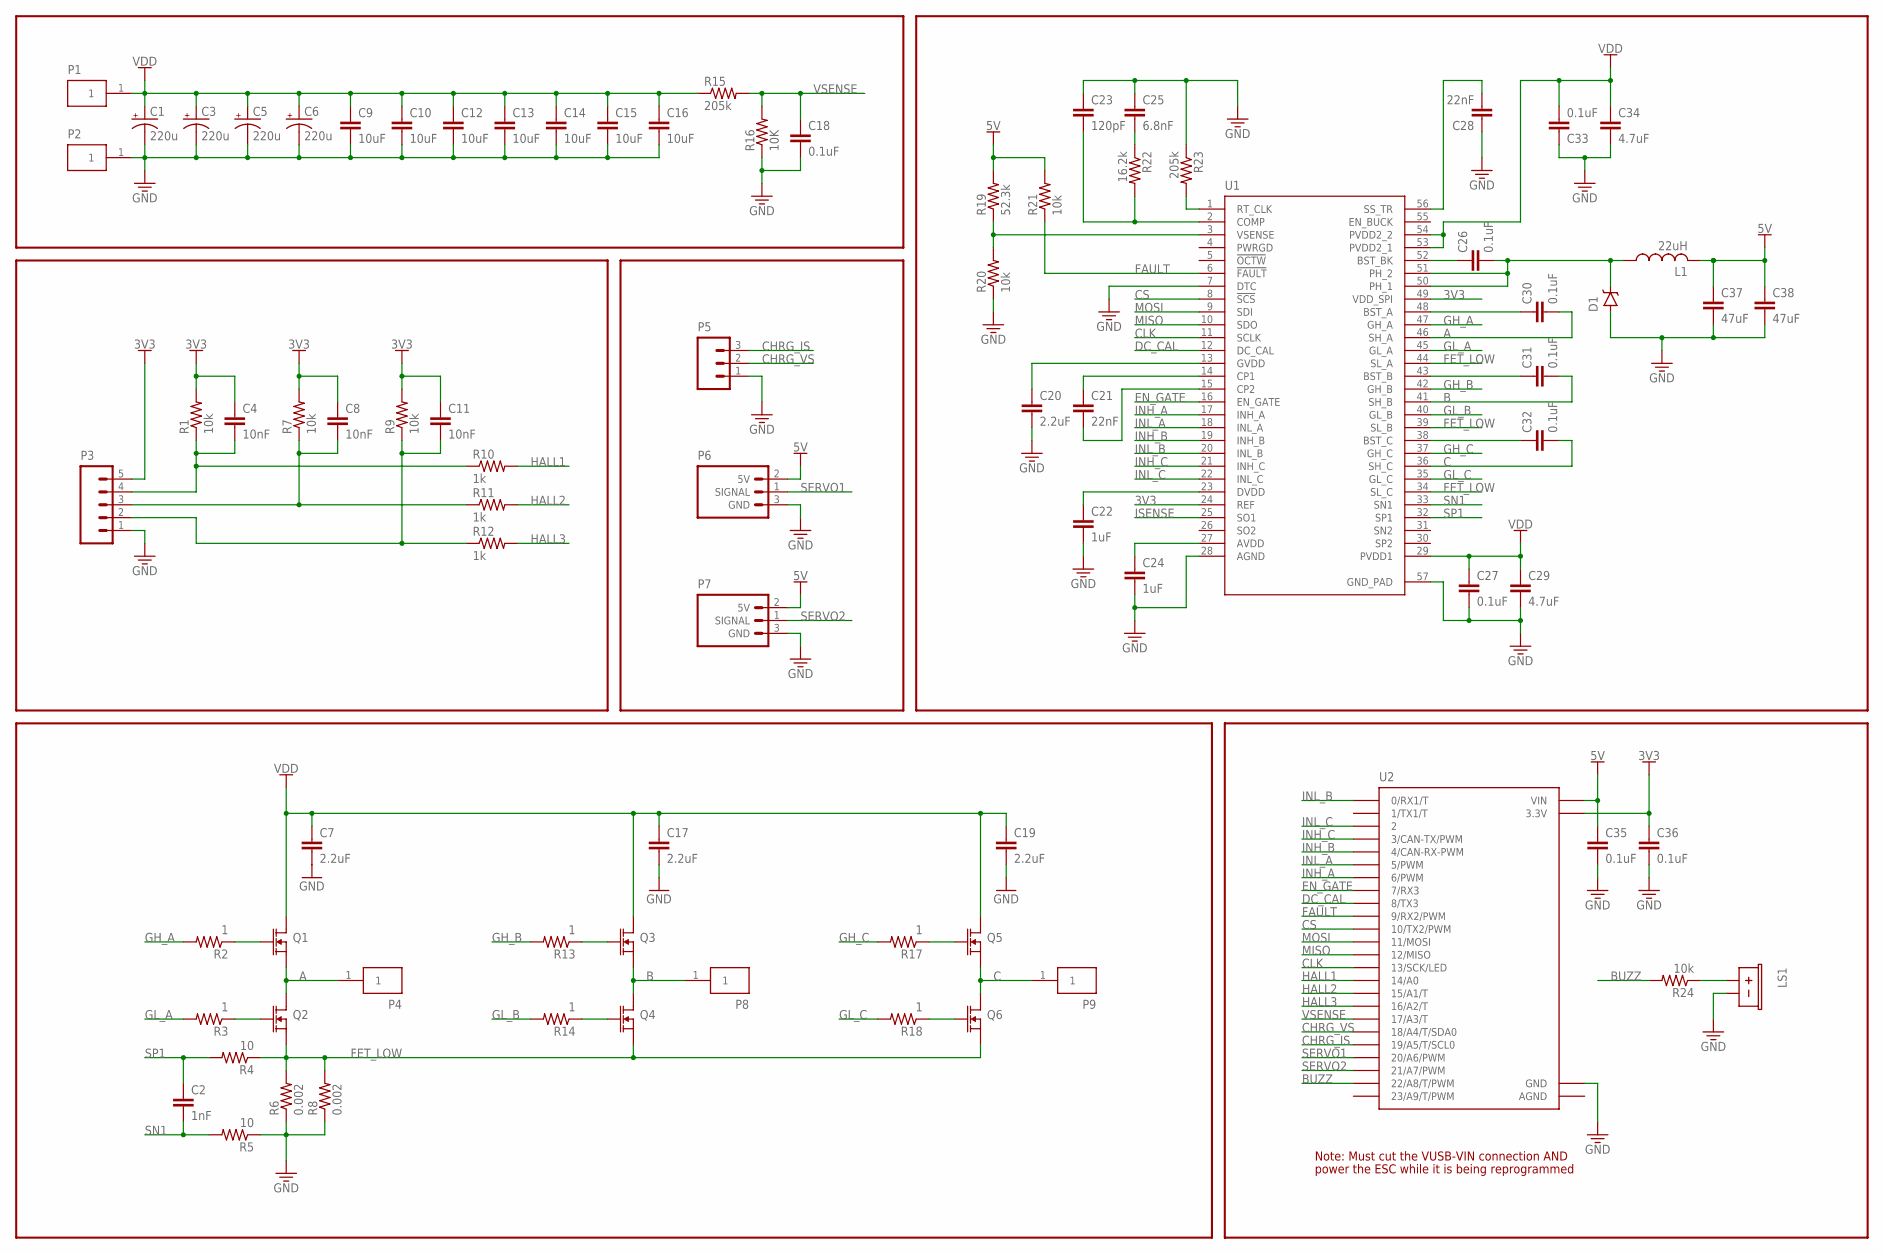
[picture p107: schematic hybrid_esc.sch]

Parts:
C1, C3, C5, C6: 220u; CPOL_10_5
C2: 1nF; C0603
C4, C8, C11: 10nF; C0603
C7, C17, C19: 2.2uF; C1206
C9, C10, C12, C13, C14, C15, C16: 10uF; C1206
C18, C26, C27, C30, C31, C32, C33, C35, C36: 0.1uF; C0603
C20: 2.2uF; C0603
C21, C28: 22nF; C0603
C22, C24: 1uF; C0603
C23: 120pF; C0603
C25: 6.8nF; C0603
C29, C34: 4.7uF; C1206
C37, C38: 47uF; C1206
D1: D_SOD123W; SOD123W
L1: 22uH; SDR0805
LS1: BUZZER_12MM
P1, P2, P4, P8, P9: POWER_PAD
P3: JST-XH5
P5: CONN_03
P6, P7: SERVO
Q1, Q2, Q3, Q4, Q5, Q6: NFET_D2PAK-7; D2PAK-7
R1, R7, R9, R20, R21, R24: 10k; R0603
R2, R3, R13, R14, R17, R18: 1; R0603
R4, R5: 10; R0603
R6, R8: 0.002; R2512
R10, R11, R12: 1k; R0603
R15, R23: 205k; R0603
R16: 10K; R0603
R19: 52.3k; R0603
R22: 16.2k; R0603
U1: DRV8301; TSSOP56P
U2: TEENSY_3.1

Connections:
3V3: C4.1, C8.1, C11.1, C36.1, P3.5, R1.2, R7.2, R9.2, U1.24 (REF), U1.49 (VDD_SPI), U2.3.3V
5V: C35.1, C37.1, C38.1, L1.2, P6.2 (5V), P7.2 (5V), R19.2, R21.2, U2.VIN
A: C30.2, P4.1, Q1.S, Q1.S1 (S), Q1.S2 (S), Q1.S3 (S), Q1.S4 (S), Q2.D, U1.46 (SH_A)
AGND: U2.AGND
B: C31.2, P8.1, Q3.S, Q3.S1 (S), Q3.S2 (S), Q3.S3 (S), Q3.S4 (S), Q4.D, U1.41 (SH_B)
BUZZ: R24.2, U2.22/A8 (22/A8/T/PWM)
C: C32.2, P9.1, Q5.S, Q5.S1 (S), Q5.S2 (S), Q5.S3 (S), Q5.S4 (S), Q6.D, U1.36 (SH_C)
CHRG_IS: P5.3, U2.19/A5 (19/A5/T/SCL0)
CHRG_VS: P5.2, U2.18/A4 (18/A4/T/SDA0)
CLK: U1.11 (SCLK), U2.13 (13/SCK/LED)
CS: U1.8 (!SCS), U2.10 (10/TX2/PWM)
DC_CAL: U1.12 (DC_CAL), U2.8 (8/TX3)
EN_GATE: U1.16 (EN_GATE), U2.7 (7/RX3)
FAULT: R21.1, U1.6 (!FAULT), U2.9 (9/RX2/PWM)
FET_LOW: Q2.S, Q2.S1 (S), Q2.S2 (S), Q2.S3 (S), Q2.S4 (S), Q4.S, Q4.S1 (S), Q4.S2 (S), Q4.S3 (S), Q4.S4 (S), Q6.S, Q6.S1 (S), Q6.S2 (S), Q6.S3 (S), Q6.S4 (S), R4.1, R6.2, R8.2, U1.34 (SL_C), U1.39 (SL_B), U1.44 (SL_A)
GH_A: R2.2, U1.47 (GH_A)
GH_B: R13.2, U1.42 (GH_B)
GH_C: R17.2, U1.37 (GH_C)
GL_A: R3.2, U1.45 (GL_A)
GL_A': Q2.G, R3.1
GL_B: R14.2, U1.40 (GL_B)
GL_B': Q4.G, R14.1
GL_C: R18.2, U1.35 (GL_C)
GL_C': Q6.G, R18.1
GND: C1.-, C3.-, C5.-, C6.-, C7.2, C9.2, C10.2, C12.2, C13.2, C14.2, C15.2, C16.2, C17.2, C18.2, C19.2, C20.2, C22.2, C23.1, C24.2, C25.1, C27.2, C28.1, C29.2, C33.1, C34.2, C35.2, C36.2, C37.2, C38.2, D1.A, LS1.-, P2.1, P3.1, P5.1, P6.3 (GND), P7.3 (GND), R5.1, R6.1, R8.1, R16.1, R20.1, R23.1, U1.7 (DTC), U1.28 (AGND), U1.57 (GND_PAD), U2.GND
HALL1: R10.2, U2.14/A0
HALL2: R11.2, U2.15/A1 (15/A1/T)
HALL3: R12.2, U2.16/A2 (16/A2/T)
INH_A: U1.17 (INH_A), U2.6 (6/PWM)
INH_B: U1.19 (INH_B), U2.4 (4/CAN-RX-PWM)
INH_C: U1.21 (INH_C), U2.3 (3/CAN-TX/PWM)
INL_A: U1.18 (INL_A), U2.5 (5/PWM)
INL_B: U1.20 (INL_B), U2.0 (0/RX1/T)
INL_C: U1.22 (INL_C), U2.2
ISENSE: U1.25 (SO1)
MISO: U1.10 (SDO), U2.12 (12/MISO)
MOSI: U1.9 (SDI), U2.11 (11/MOSI)
unnamed: Q3.G, R13.1
unnamed: R19.1, R20.2, U1.3 (VSENSE)
unnamed: C23.2, R22.2, U1.2 (COMP)
unnamed: C22.1, U1.23 (DVDD)
unnamed: Q5.G, R17.1
unnamed: C28.2, U1.56 (SS_TR)
unnamed: C25.2, R22.1
unnamed: C26.1, U1.52 (BST_BK)
unnamed: Q1.G, R2.1
unnamed: R23.2, U1.1 (RT_CLK)
unnamed: C4.2, P3.4, R1.1, R10.1
unnamed: LS1.+, R24.1
unnamed: C8.2, P3.3, R7.1, R11.1
unnamed: C11.2, P3.2, R9.1, R12.1
unnamed: C32.1, U1.38 (BST_C)
unnamed: C21.1, U1.14 (CP1)
unnamed: C24.1, U1.27 (AVDD)
unnamed: C21.2, U1.15 (CP2)
unnamed: C20.1, U1.13 (GVDD)
unnamed: C31.1, U1.43 (BST_B)
unnamed: C30.1, U1.48 (BST_A)
unnamed: C26.2, D1.C, L1.1, U1.50 (PH_1), U1.51 (PH_2)
SERVO1: P6.1 (SIGNAL), U2.20/A6 (20/A6/PWM)
SERVO2: P7.1 (SIGNAL), U2.21/A7 (21/A7/PWM)
SN1: C2.2, R5.2, U1.33 (SN1)
SP1: C2.1, R4.2, U1.32 (SP1)
VDD: C1.+, C3.+, C5.+, C6.+, C7.1, C9.1, C10.1, C12.1, C13.1, C14.1, C15.1, C16.1, C17.1, C19.1, C27.1, C29.1, C33.2, C34.1, P1.1, Q1.D, Q3.D, Q5.D, R15.1, U1.29 (PVDD1), U1.53 (PVDD2_1), U1.54 (PVDD2_2)
VSENSE: C18.1, R15.2, R16.2, U2.17/A3 (17/A3/T)

Notes on the sheet:
Note: Must cut the VUSB-VIN connection AND
power the ESC while it is being reprogrammed

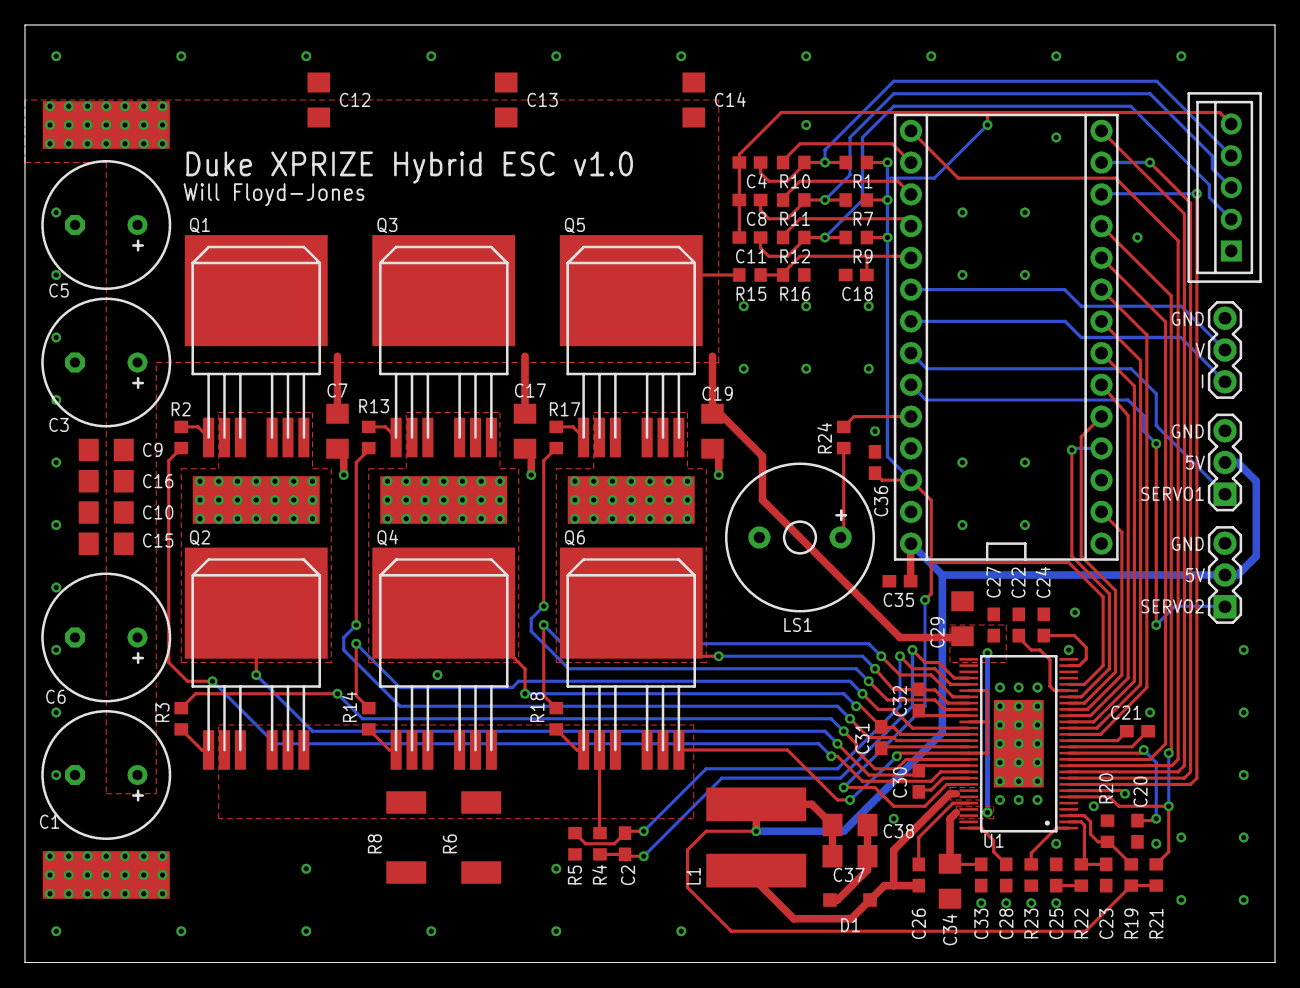
[picture p108: board hybrid_esc.brd from above]

Board: 2 copper layers, 100.0 x 75.0 mm, 82 parts (0 on the bottom side), 63 nets.
