rua0/Duke_Xprize_Hybrid/(commit log)

2018-06-21 Initial Upload
    Code base. Tuning needed
    [BOM.xlsx, Power Calculations.xlsx, Purchase Order 10_22.xlsx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]
2018-06-22 Tests to tune throttle position
    min is 285 ticks, wide open;
    max is 340 ticks, closed
2018-06-22 Tuned upper tick bound for throttle
    Changed max pulse length param for throttle and made upper tick bound 350 (obtained by experiment)
2018-06-22 Tuned for servos
    Tuned for parameters on throttle and choke servos
2018-06-22 ESC Tuning
2018-06-27 Change sequence instructions
    Changed instructions for different sequences. Hopefully it works for test today
    [List of Parts Needed for Hydro Team.xlsx]
2018-06-27 Tuning
    Changed ESC PL min.
    11 percent to start from no movement
2018-07-30 Current sensor
